TylerM-Personal/Golf_Ball_Color_Sorting_Robot/(commit log)

2026-10-15 Refresh portfolio README and add architecture diagrams
    Add diagrams for the color-sorting robot, EV3 hockey robot, and thermostat fan. Update the root README with project summaries and direct source links.
2026-10-15 Add smart thermostat fan firmware source
    Add the MSPM0G3507 C and assembly project files, peripheral support code, linker command file, and project notes.
